DmitryGofman/bench-project/folding-V2/ref-video-bench.jpg

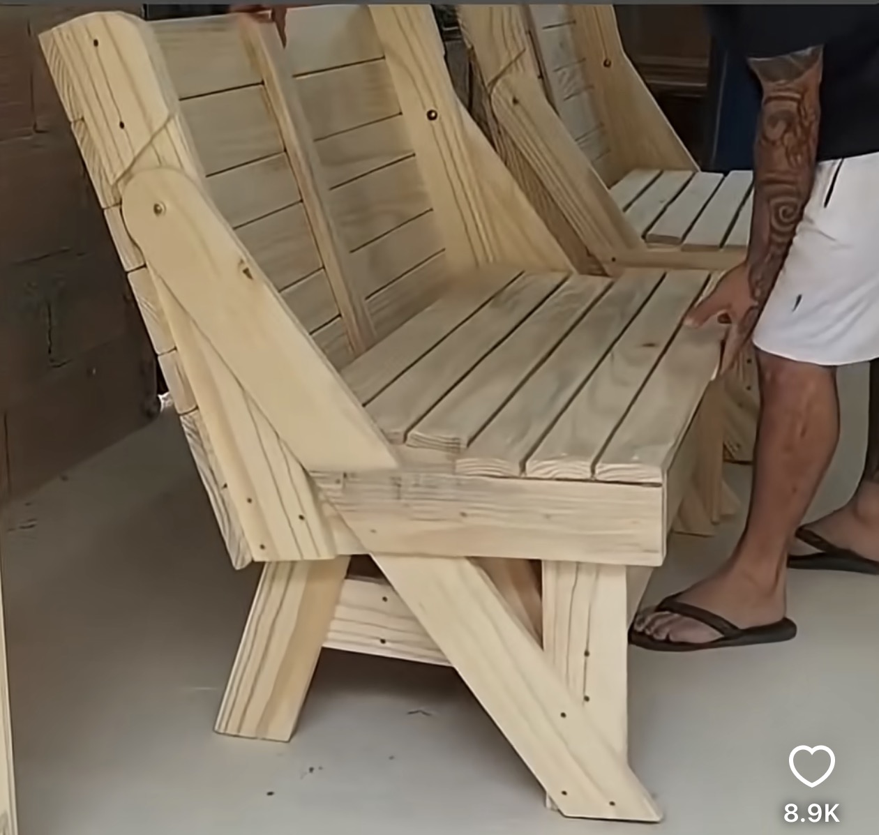
folding-V2/ref-video-bench.jpg
