DmitryGofman/bench-project/simple-G1/research.md

Reviewed 13 October 2026.

BuildEazy / Les Kenny: one-piece adult folding table, four pivots and three rigid assemblies. https://www.buildeazy.com/folding-picnic-table-out-of-2x4-lumber/

Compact adult alternative, with armrests acting as spread stops: https://www.buildeazy.com/compact-folding-picnic-table/

The supplied 814 × 493 mm diagram belongs to a children’s design: https://www.buildeazy.com/kids-2in1-picnic-table/

Our model is independently dimensioned and is not an exact reproduction of either published plan. Author drawings are linked, not redistributed. Images supplied by the user are visual references. The M3U8 files only reference absent local child playlists; they contain no playable video.
