DmitryGofman/bench-project/folding-V2/sketch.png

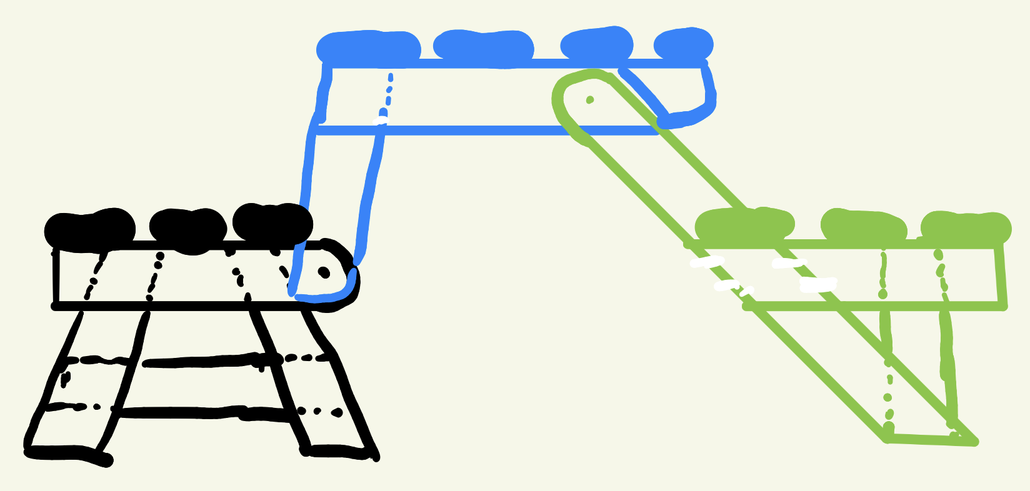
folding-V2/sketch.png
