DmitryGofman/bench-project/simple-G1/full-bom.csv

ID | Name | Assembly | Qty | Finished thickness mm | Finished width mm | Blank length mm | End 1 deg | End 2 deg | Machining / notes
 | Back board | back | 3 | 22 | 95 | 1160 | 0 | 0 | See assembly drawing
 | Long seat rail | rail | 2 | 45 | 95 | 1070 | 0 | 0 | See assembly drawing
 | Seat board | slat | 4 | 32 | 95 | 1070 | 0 | 0 | See assembly drawing
 | Rear upright | post | 2 | 45 | 95 | 870 | 0 | 0 | See assembly drawing
 | Front leg | post | 2 | 45 | 95 | 418 | 0 | 0 | See assembly drawing
 | Side seat rail | rail | 2 | 45 | 95 | 360 | 0 | 0 | See assembly drawing
 | Intermediate bearer | rail | 1 | 45 | 95 | 360 | 0 | 0 | See assembly drawing
HW-S1 | 6 × 110 mm, manufacturer-rated for frame joints | Hardware | 20 |  |  |  |  |  | Frame connections: two per rail end; four per intermediate bearer. Modern arms: two per end and lower ties: two per end. Verify screw angle and embedment at each butt joint.
HW-S2 | 5 × 70 mm | Hardware | 24 |  |  |  |  |  | Two per seat board at each end rail and each intermediate bearer; stagger to avoid splitting.
HW-S3 | 5 × 60 mm | Hardware | 12 |  |  |  |  |  | Two per board at each rear upright; holes on upright centre lines.
HW-S4 | Galvanized or stainless 50 × 50 mm minimum angle, compatible structural fixings | Hardware | 8 |  |  |  |  |  | Reinforce seat perimeter and modern lower ties against racking; choose rated brackets matching stock thickness.
HW-S5 | Bracket-manufacturer approved exterior connector screws | Hardware | 32 |  |  |  |  |  | Four per bracket allowance; follow actual bracket hole and load specification.
HW-S6 | Non-absorbent exterior feet fitting 45 × 95 mm posts | Hardware | 4 |  |  |  |  |  | Pad thickness adds to the overall height.
