DmitryGofman/bench-project/folding-V2/hardware.csv

Section | ID | Qty / type | Specification | Detail
hardware | H01 | 4 | M10×70 hex bolt, ISO 4017, A4-70 stainless (or HDG 8.8) | Pivots A and B, one per pivot per side.
hardware | H02 | 4 | M10 nyloc nut, ISO 10511, A4 | Torque fully: the bolt clamps the sleeve, not the timber.
hardware | H03 | 8 | M10 flat washer ISO 7089 (Ø20×2), A4 | Head and nut side of each pivot.
hardware | H04 | 4 | Pivot sleeve: stainless tube OD14 × 1.5 wall, cut 54.5 long, ends square | 79 timber stack − 10 − 15 counterbores + 0.5 float.
hardware | H05 | 8 | Plain bushing ID14 / OD18 × 20, oil-impregnated sintered bronze (or POM) | One in each member at each pivot, flush with the moving face.
hardware | H06 | 4 | Thrust washer UHMW-PE, ID14.5 / OD40 / 3.0 | Between the moving faces at each pivot.
hardware | H07 | 2 | Ball-lock quick-release pin Ø10, stainless, grip ≥ 80, with lanyard | Optional (the video uses a rope). One per side, through F1 into T1 ("table" or "bench" hole): keeps the front seat from swinging while you lift the table.
hardware | H08 | 8 | M8×80 hex bolt + 2 × ISO 7089 washers + M8 nyloc, A4 | Strut to apron (2 per side), T3 and T4 to apron (1 each per side). Counterbore Ø24×12 where a face moves past another part.
hardware | H09 | 104 | Exterior structural screw 5×70, countersunk Torx | 94 fitted + 10% spare. Countersink flush.
hardware | H11 | 1 | Exterior PU / D4 wood adhesive | All fixed laps. Not on moving faces.
hardware | H12 | 2 | M8×130 hex bolt + 2 × ISO 7089 washers + M8 nyloc, A4 | Bench stop R5 through stretcher R4 and leg R3, 1 per side.
interface | P-A | pivot bearing | Pivot A · F1 ↔ T1 | M10 bolt clamps a Ø14 stainless sleeve; both members on Ø14/Ø18 bushings; 3 mm UHMW thrust washer. Counterbore Ø30: 10 deep on F1 outer face, 15 deep on T1 inner face.
interface | P-B | pivot bearing | Pivot B · T2 ↔ R1 | Same stack as A. Counterbore Ø30: 10 deep on T2 outer face, 15 deep on R1 inner face.
interface | ST-T | hard stop | T3 ↔ F1 (table) | T3 face lies on the arm in table pose: the table cannot open past flat and the arm cannot swing out.
interface | ST-B | hard stop | T4 ↔ F1 (bench) | T4 face lies on the arm in bench pose: the arm cannot fold further against the backrest.
interface | ST-S | hard stop | R5 ↔ T2 (bench) | The strut lands on R5 in bench pose: the backrest cannot tip further back, even if the front seat rocks.
interface | FL | support | F1 + F3 feet ↔ floor (both poses) | The front seat stands on two feet, so the floor sets it level in table and bench pose.
interface | SUP | support contact | S3 ↔ R1 (bench) | In bench pose the front seat boards rest on the bare front part of R1 (0 … 55), in front of the rear seat.
interface | LK | positive lock | Lock pin L · F1 ↔ T1 | Ø10 ball-lock pin; one Ø10.5 hole in F1, two in T1 (table / bench) 34 mm from A. Match-drill in each pose.
joint | J01 | glued lap | R1 -> R2 | Exterior PU glue + 3 × 5×70 screws · from R1 outer face into R2
joint | J02 | glued lap | R1 -> R3 | Exterior PU glue + 3 × 5×70 screws · from R1 outer face into R3
joint | J03 | glued lap | R4 -> R2 | Exterior PU glue + 3 × 5×70 screws · from R4 outer face into R2
joint | J04 | glued lap | R4 -> R3 | Exterior PU glue + 2 × 5×70 screws (+ the R5 bolt) · from R4 outer face into R3
joint | J05.1 | board to rail | S1-1 -> R1 | 2 × 5×70 screws per board end, pilot Ø3, countersunk · down through board face, X = ±571
joint | J05.2 | board to rail | S1-2 -> R1 | 2 × 5×70 screws per board end, pilot Ø3, countersunk · down through board face, X = ±571
joint | J05.3 | board to rail | S1-3 -> R1 | 2 × 5×70 screws per board end, pilot Ø3, countersunk · down through board face, X = ±571
joint | J14 | glued + bolted lap | R5 -> R4 + R3 | Exterior PU glue + 1 × M8×130 through R5, R4 and R3 · through
joint | J06 | bolted lap | T1 -> T2 | M8×80 hex bolt + 2 washers + nyloc, counterbored Ø24×12 both faces, glued · through
joint | J12 | glued + bolted lap | T3 -> T1 | Exterior PU glue + 1 × M8×80 + 2 × 5×70 screws · from T3 outer face into T1
joint | J13 | glued + bolted lap | T4 -> T1 | Exterior PU glue + 1 × M8×80 + 2 × 5×70 screws · from T4 outer face into T1
joint | J07.1 | board to rail | S2-1 -> T1 | 2 × 5×70 screws per board end, pilot Ø3, countersunk · down through board face, X = ±650
joint | J07.2 | board to rail | S2-2 -> T1 | 2 × 5×70 screws per board end, pilot Ø3, countersunk · down through board face, X = ±650
joint | J07.3 | board to rail | S2-3 -> T1 | 2 × 5×70 screws per board end, pilot Ø3, countersunk · down through board face, X = ±650
joint | J07.4 | board to rail | S2-4 -> T1 | 2 × 5×70 screws per board end, pilot Ø3, countersunk · down through board face, X = ±650
joint | J07.5 | board to rail | S2-5 -> T1 | 2 × 5×70 screws per board end, pilot Ø3, countersunk · down through board face, X = ±650
joint | J07.6 | board to rail | S2-6 -> T1 | 2 × 5×70 screws per board end, pilot Ø3, countersunk · down through board face, X = ±650
joint | J07.7 | board to rail | S2-7 -> T1 | 2 × 5×70 screws per board end, pilot Ø3, countersunk · down through board face, X = ±650
joint | J08 | glued lap | F1 -> F2 | Exterior PU glue + 3 × 5×70 screws · from F1 outer face into F2
joint | J09 | glued lap | F2 -> F3 | Exterior PU glue + 3 × 5×70 screws · from F2 outer face into F3
joint | J11.1 | board to rail | S3-1 -> F2 | 2 × 5×70 screws per board end, pilot Ø3, countersunk · down through board face, X = ±653
joint | J11.2 | board to rail | S3-2 -> F2 | 2 × 5×70 screws per board end, pilot Ø3, countersunk · down through board face, X = ±653
joint | J11.3 | board to rail | S3-3 -> F2 | 2 × 5×70 screws per board end, pilot Ø3, countersunk · down through board face, X = ±653
