DmitryGofman/bench-project/simple-G1/hardware.csv

ID | Quantity | Specification | Detail
HW-S1 | 20 | 6 × 110 mm, manufacturer-rated for frame joints | Frame connections: two per rail end; four per intermediate bearer. Modern arms: two per end and lower ties: two per end. Verify screw angle and embedment at each butt joint.
HW-S2 | 24 | 5 × 70 mm | Two per seat board at each end rail and each intermediate bearer; stagger to avoid splitting.
HW-S3 | 12 | 5 × 60 mm | Two per board at each rear upright; holes on upright centre lines.
HW-S4 | 8 | Galvanized or stainless 50 × 50 mm minimum angle, compatible structural fixings | Reinforce seat perimeter and modern lower ties against racking; choose rated brackets matching stock thickness.
HW-S5 | 32 | Bracket-manufacturer approved exterior connector screws | Four per bracket allowance; follow actual bracket hole and load specification.
HW-S6 | 4 | Non-absorbent exterior feet fitting 45 × 95 mm posts | Pad thickness adds to the overall height.
