DmitryGofman/bench-project/folding-V2/schedule.csv

label | qty | cut_length_mm | end_cuts | section | laminations | boards | total_mm | mass_kg
S2 · Table / backrest board | 7 | 1520 | square | 38×89 | 1 | 7 | 10640 | 17.99
S3 · Front seat board | 3 | 1344 | square | 38×89 | 1 | 3 | 4032 | 6.82
S1 · Rear seat board | 3 | 1180 | square | 38×89 | 1 | 3 | 3540 | 5.99
F1 · Arm (table leg) | 2 | 941 | square | 38×89 | 1 | 2 | 1882 | 3.18
T1 · Table apron / backrest post | 2 | 659 | square | 38×89 | 1 | 2 | 1318 | 2.23
R2 · Rear frame front leg | 2 | 451 | square | 38×89 | 1 | 2 | 902 | 1.53
R3 · Rear frame back leg | 2 | 451 | square | 38×89 | 1 | 2 | 902 | 1.53
F2 · Front seat rail | 2 | 443 | square | 38×89 | 1 | 2 | 886 | 1.50
F3 · Front seat leg | 2 | 412 | square | 38×89 | 1 | 2 | 824 | 1.39
T2 · Strut | 2 | 404 | square | 38×89 | 1 | 2 | 808 | 1.37
R1 · Rear seat rail | 2 | 380 | square | 38×89 | 1 | 2 | 760 | 1.29
R4 · Rear frame stretcher | 2 | 350 | square | 38×89 | 1 | 2 | 700 | 1.18
T3 · Table stop | 2 | 255 | square | 38×89 | 1 | 2 | 510 | 0.86
R5 · Bench stop | 2 | 247 | square | 38×89 | 1 | 2 | 494 | 0.84
T4 · Bench stop | 2 | 233 | square | 38×89 | 1 | 2 | 466 | 0.79
