DmitryGofman/bench-project/simple-G1/profiles-mm.dxf

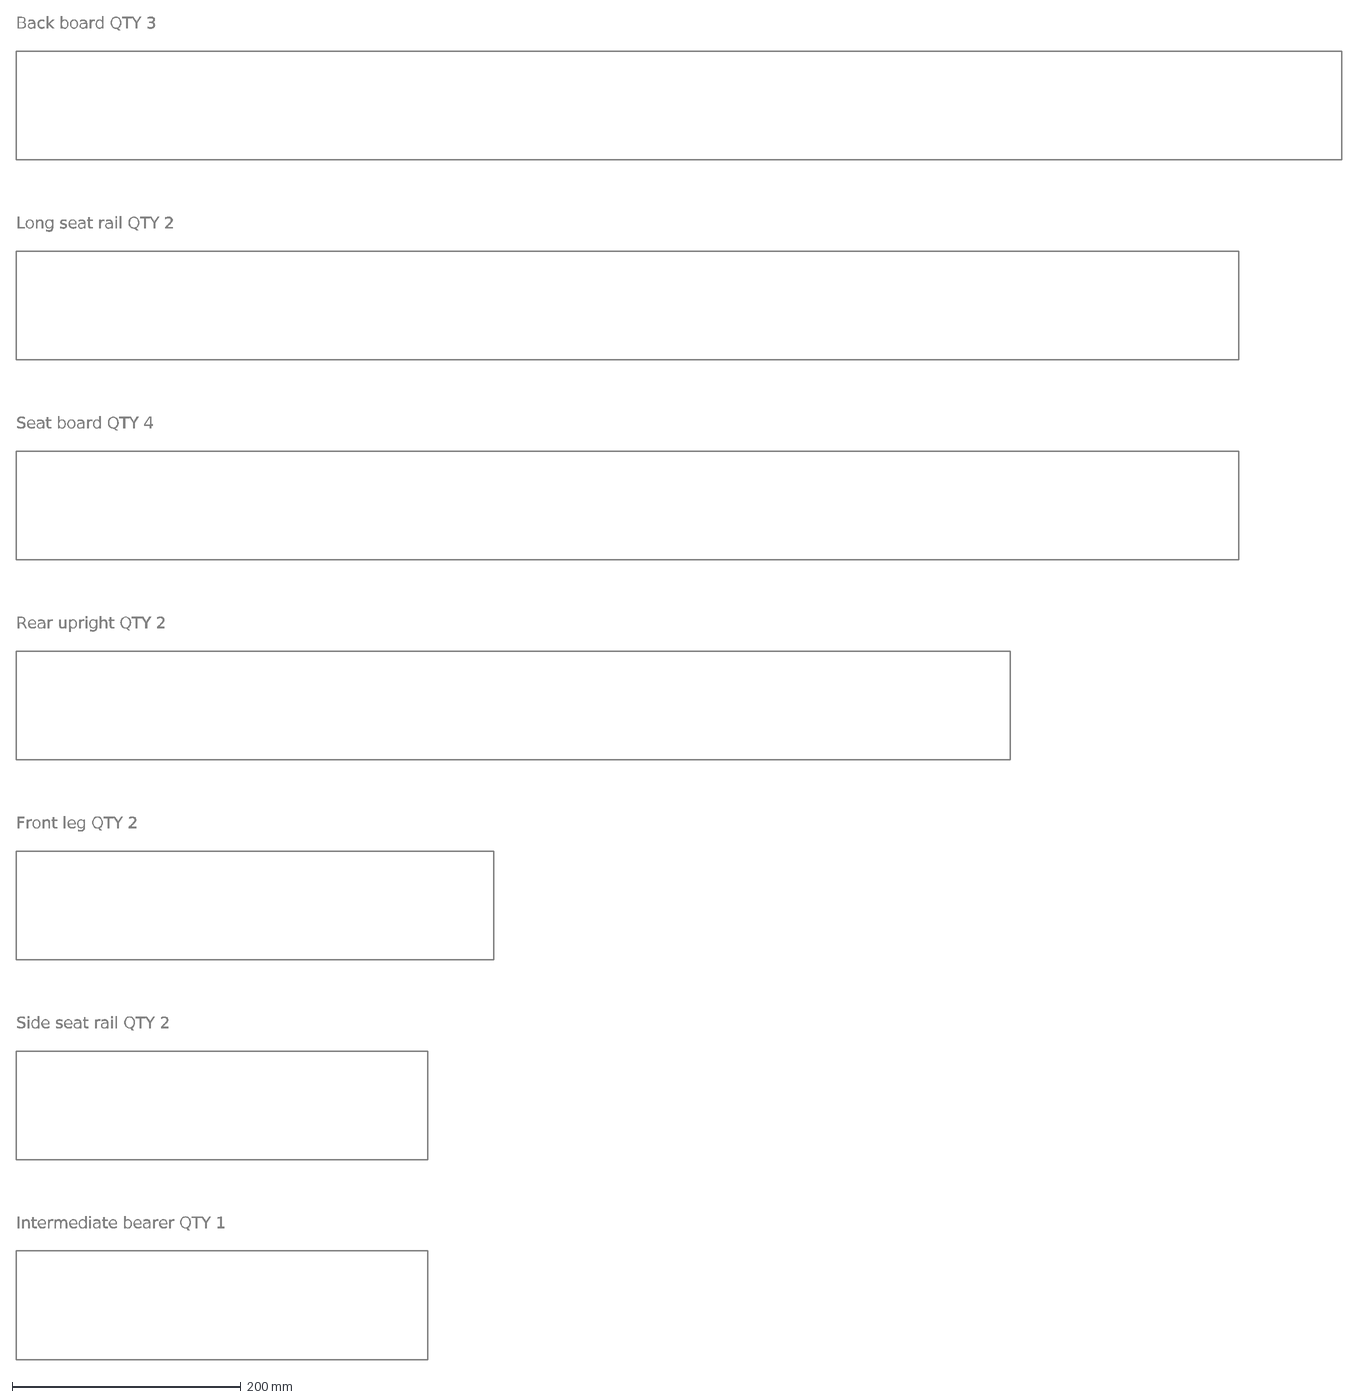
[picture p3: CAD file, 2026-10-13]
simple-G1/profiles-mm.dxf
Back board QTY 3
Long seat rail QTY 2
Seat board QTY 4
Rear upright QTY 2
Front leg QTY 2
Side seat rail QTY 2
Intermediate bearer QTY 1
