DmitryGofman/bench-project/simple-G1/fabrication-register.md

# Simple garden bench — fabrication register

All dimensions mm. Generated from the current design.

## All timber
All ends square; no hidden laps, rebates or compound mitres. Dimensions are finished stock sizes. Break exposed edges 2–3 mm.

## Frame joints
Rails butt against posts and bearer ends butt against long rails. Brackets are required against racking; timber solids do not model screw holes or bracket plates.

## Seat board drilling
Two holes per support, across each board width at 20 mm from its edges. Support stations measured from inner seat left end: 22.5 (end support), 535, 1048 mm (end support). Move end holes onto actual side rail centre lines; do not drill at the board end.

## Back board drilling
Upright centre lines at 22.5 and 1137.5 mm from board left end. Two screws per upright, 20 mm from each long edge.

## Design scope
Reference-inspired new frame geometry. Connection capacity, species/grade and user loading require workshop verification; no tested load rating is claimed.

## Parts
- 3 × Back board: 22 × 95 × 1160 blank. Square stock; see drawing.
- 2 × Long seat rail: 45 × 95 × 1070 blank. Square stock; see drawing.
- 4 × Seat board: 32 × 95 × 1070 blank. Square stock; see drawing.
- 2 × Rear upright: 45 × 95 × 870 blank. Square stock; see drawing.
- 2 × Front leg: 45 × 95 × 418 blank. Square stock; see drawing.
- 2 × Side seat rail: 45 × 95 × 360 blank. Square stock; see drawing.
- 1 × Intermediate bearer: 45 × 95 × 360 blank. Square stock; see drawing.

## Research
Reviewed 13 October 2026.

BuildEazy / Les Kenny: one-piece adult folding table, four pivots and three rigid assemblies. https://www.buildeazy.com/folding-picnic-table-out-of-2x4-lumber/

Compact adult alternative, with armrests acting as spread stops: https://www.buildeazy.com/compact-folding-picnic-table/

The supplied 814 × 493 mm diagram belongs to a children’s design: https://www.buildeazy.com/kids-2in1-picnic-table/

Our model is independently dimensioned and is not an exact reproduction of either published plan. Author drawings are linked, not redistributed. Images supplied by the user are visual references. The M3U8 files only reference absent local child playlists; they contain no playable video.
