DmitryGofman/bench-project/(commit log)

2026-10-13 Add bench project files
    Claude-Session: https://claude.ai/code/session_01JmFCknHpHW4DABhBDDnjRH
    [full-bom.csv, hardware.csv, profiles-mm.dxf]
2026-10-18 Add folding bench V2 (simple version from the video sketch)
    Three sub-assemblies, two pivots per side: rear seat on splayed legs,
    table on a straight strut pivoting on the rear rail, front seat
    triangulated by the long arm and standing on two feet. Generated by
    folding-V2/build.py and validated by planar simulation (0 clashes held
    level, 0 jams hands-off) and by the app's own clash check.
    Also restores folding-P1/rev2/app-folding-data.js so the app rebuilds,
    and lets profile parts carry their own stock width for nesting
    (P1 output unchanged).
    Claude-Session: https://claude.ai/code/session_016jBA5zxRjJoTqdvujEwVZQ
    [hardware.csv, schedule.csv]
2026-10-18 Folding bench V2: match the video — no stoppers, arm outermost, all 38x89
    Removes the table stop block (the front seat's two feet carry the
    loads), puts the arm outside the front seat rail and leg as in the
    video, sets its angle so the foot ends flush with the seat end, cuts
    the front rail's inner end along the arm, and uses 38x89 for every part
    (7 table boards, 3 boards per seat). Re-validated: 0 clashes, 0 jams.
    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
    [hardware.csv, schedule.csv]
2026-10-18 Folding bench V2: add three flush stops so it cannot over-travel
    Simulation showed the bench could fold past 100° and the table open
    past flat by rocking the front seat off its feet. Adds T3 (table end)
    and T4 (bench) as apron doublers flush with the apron, cut to the arm,
    and R5 over the back leg that takes the strut in bench pose. New
    over-travel check (pin out, front tilt within ±15°): locked both ends.
    Still 0 clashes, 0 jams, fasteners clear.
    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
    [hardware.csv, schedule.csv]
2026-10-18 Folding V2: hardware list order, part count in notes
    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
    [hardware.csv]
2026-10-19 Folding V2: front seat leg F3 lapped on the side of the rail
    F3 now runs full height on the inside face of F2 and is glued and
    screwed through from the side, replacing the butt joint with long
    screws driven down through the rail. Re-validated: 0 clashes, 0 jams,
    no over-travel, fasteners clear.
    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
    [hardware.csv, schedule.csv]
